pickand-place/controller-firmware/Schematic/Rev1.0/Schematic_rev1.0.pdf

## CAN_V3

## CAN_V3

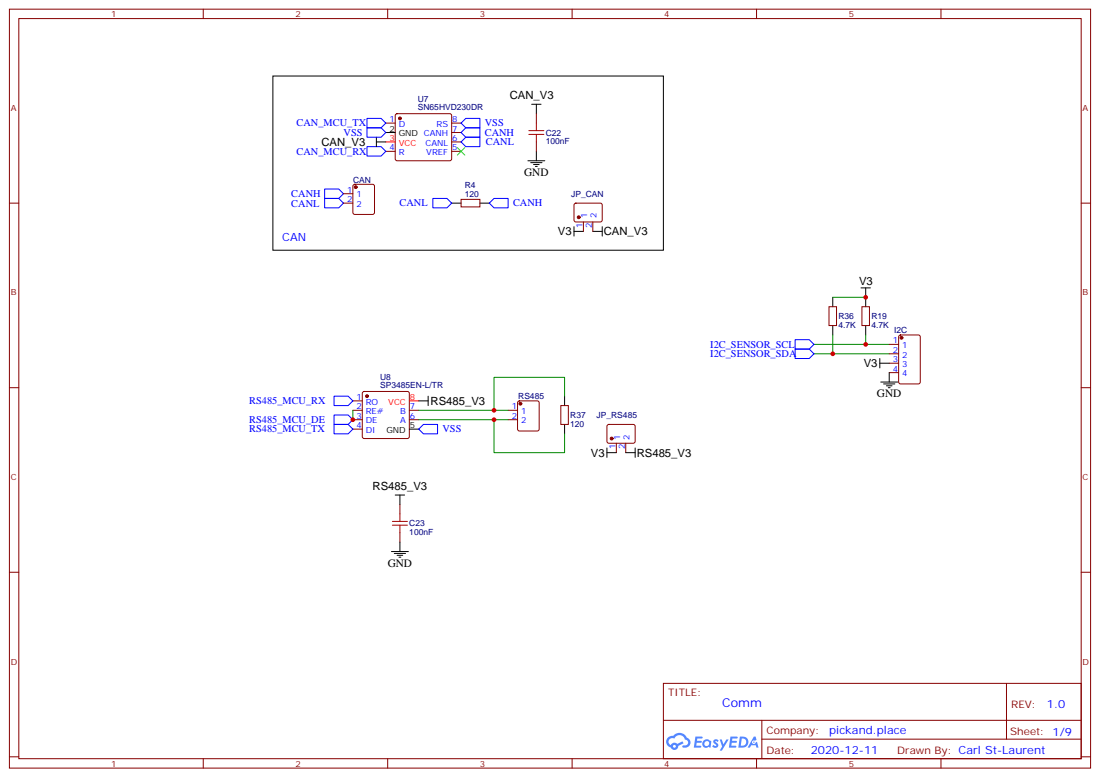
[picture p1: page 1]

Drawn By: Carl St-Laurent

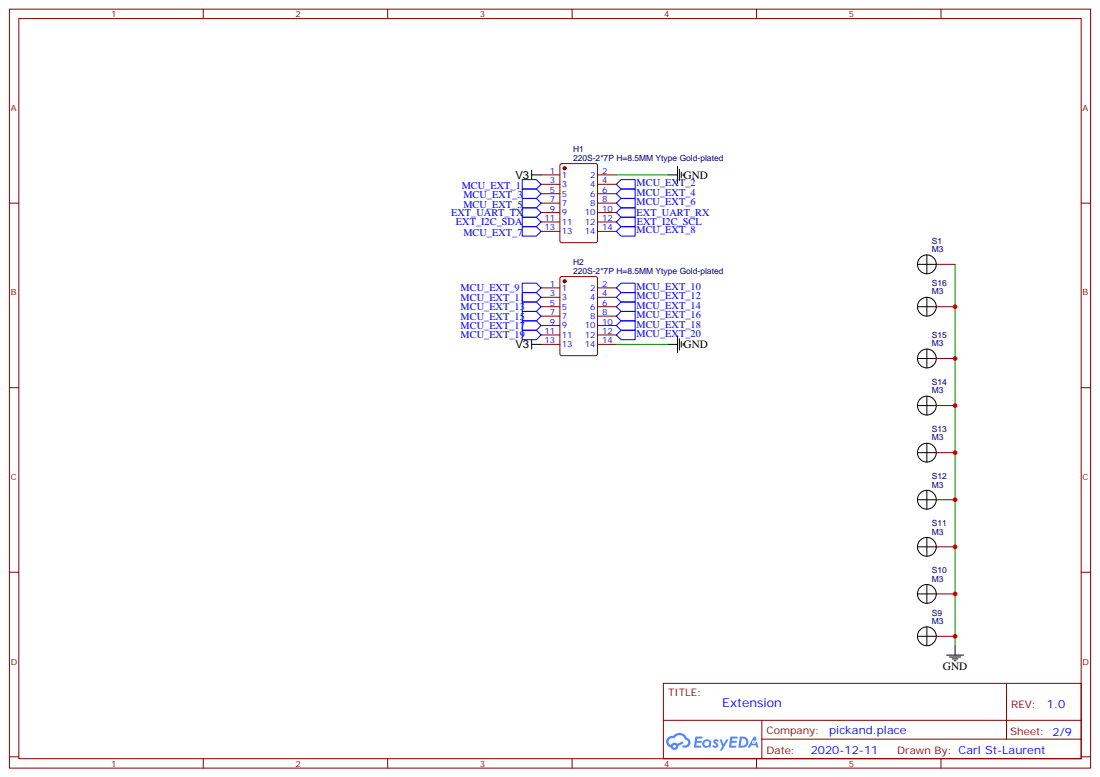
[picture p2: page 2]

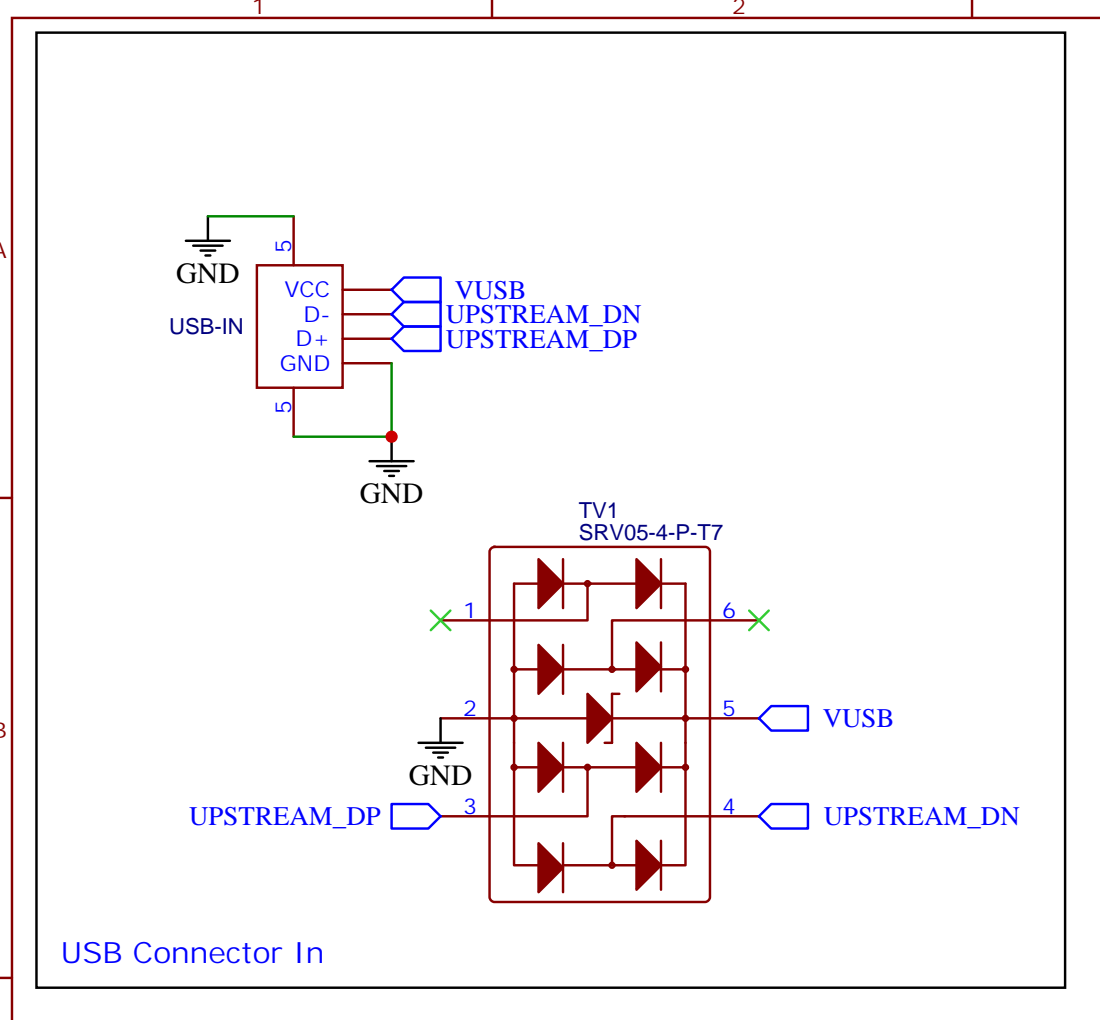
[picture p3: page 3]

## VIN

## Voltage In

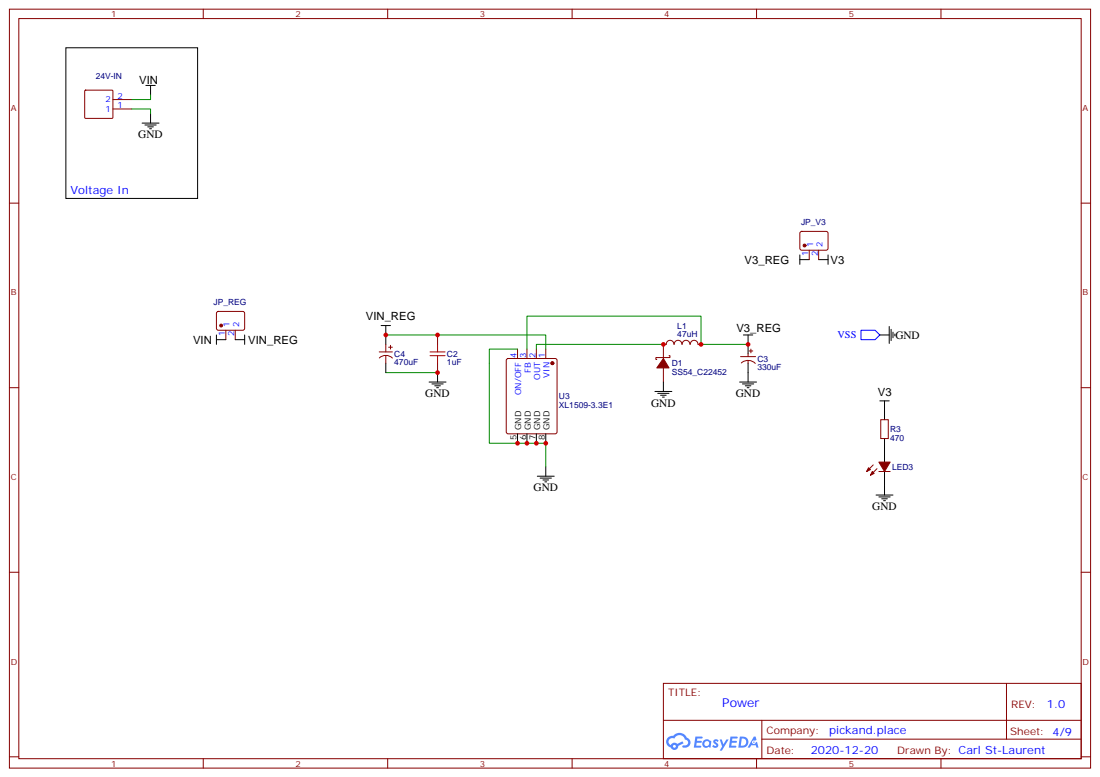
[picture p4: page 4]

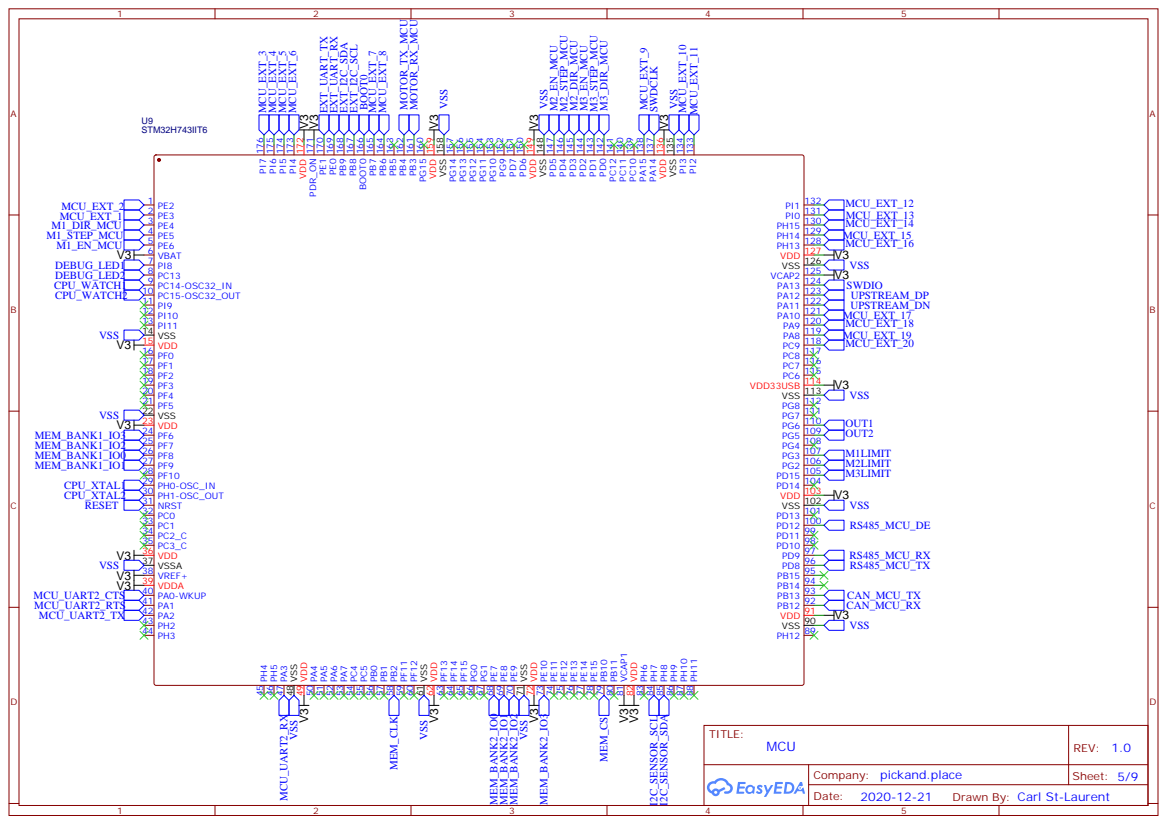
[picture p5: page 5]

V3

V3

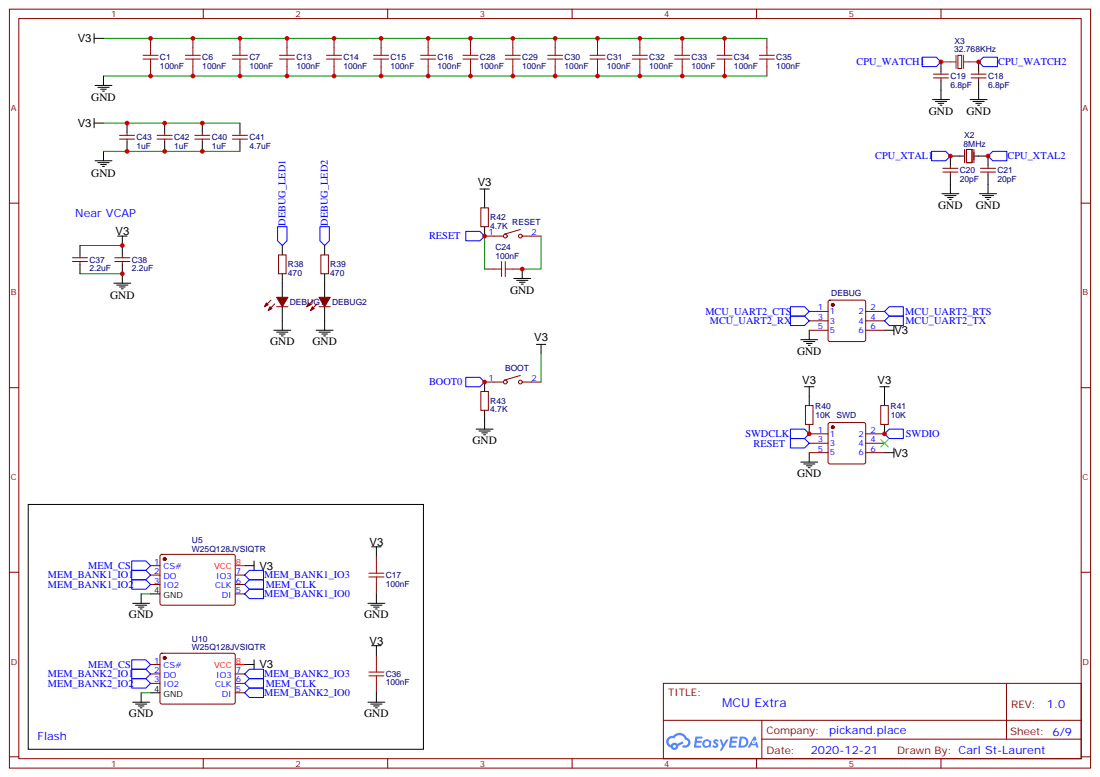
[picture p6: page 6]

## VIN

## VTMC

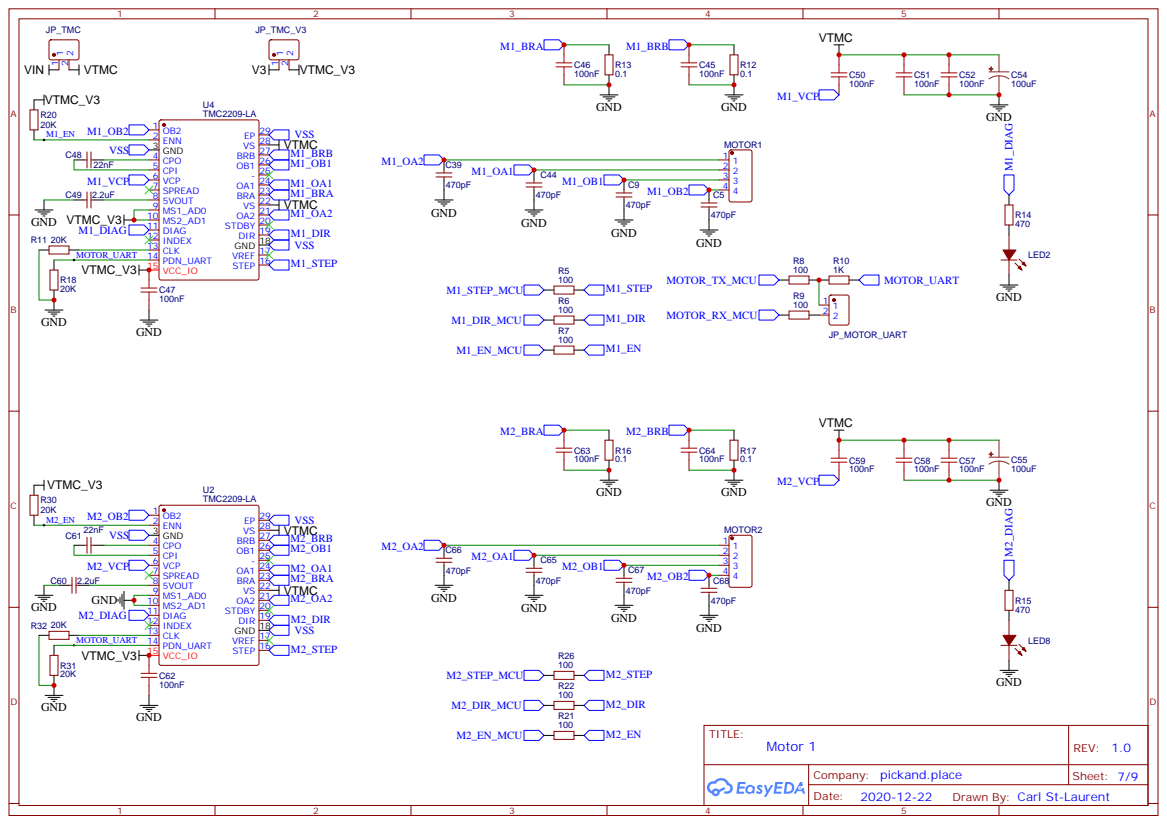
[picture p7: page 7]

## VTMC

## VTMC

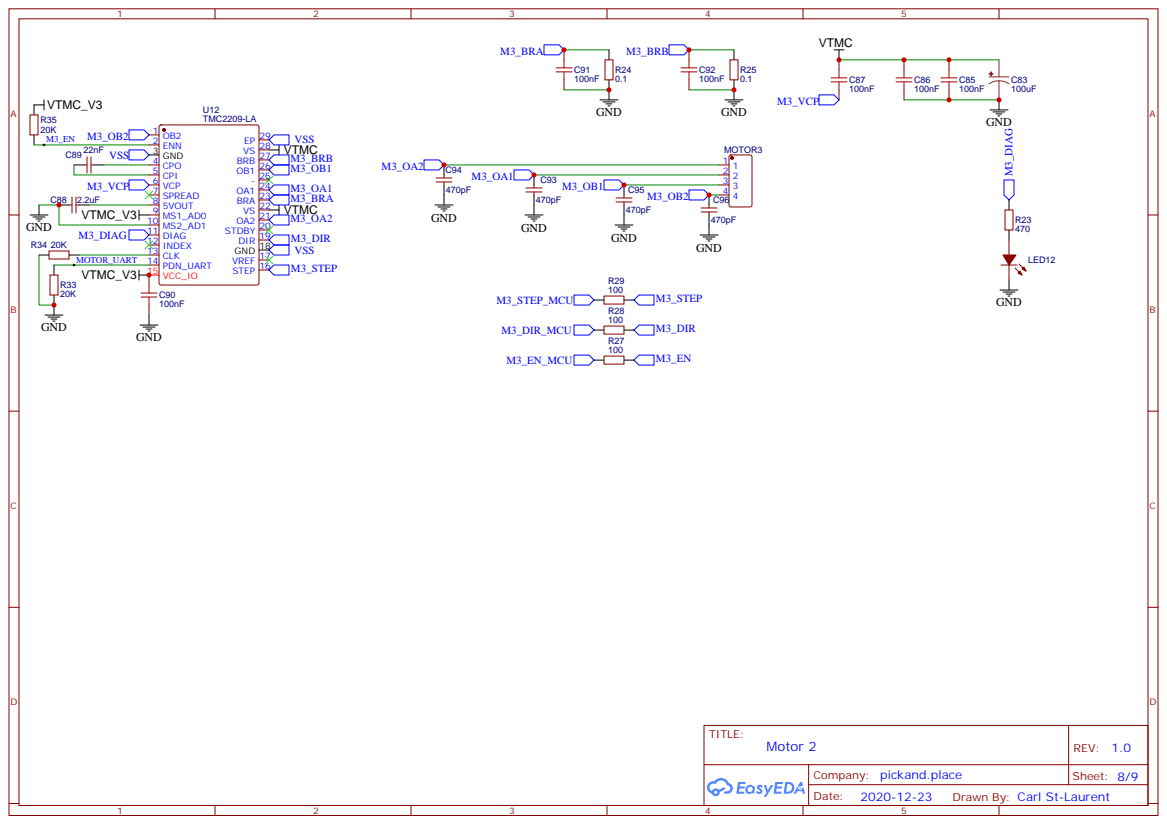
[picture p8: page 8]

V3

## VTMC

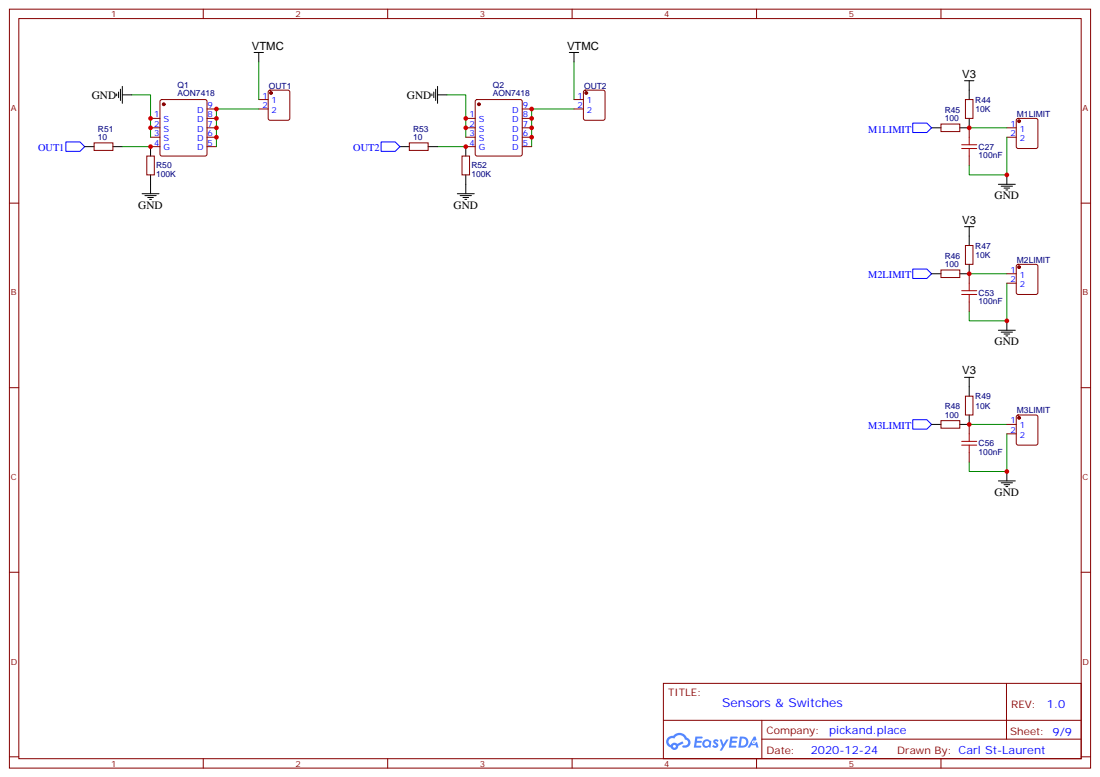
[picture p9: page 9]
