pickand-place/controller-firmware/Schematic/Rev1.0/Board_rev1.0.pdf

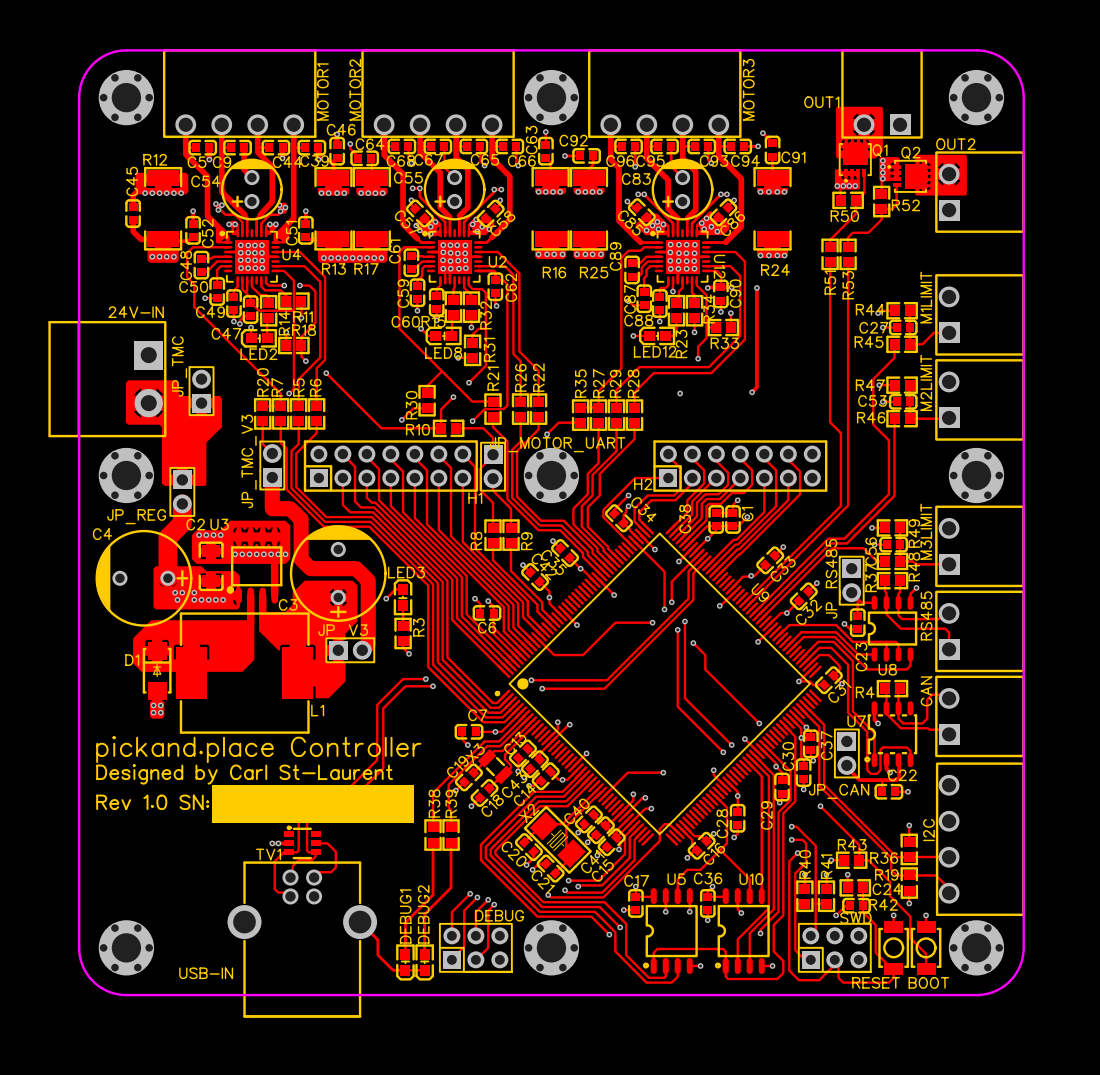
[picture p10: page 1]
