pickand-place/controller-firmware/Core/Src/main.c

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
/* Includes ------------------------------------------------------------------*/
#include "main.h"
#include "cmsis_os.h"

/* USER CODE BEGIN Includes */

#include "timers.h"

#include "tusb.h"

#include "usb_descriptors.h"

#include "retarget.h"
/* USER CODE END Includes */

typedef StaticTask_t osStaticThreadDef_t;
typedef StaticTimer_t osStaticTimerDef_t;
/* USER CODE BEGIN PD */

#define USBLED_PORT GPIOI
#define USBLED_PIN GPIO_PIN_8

#define DEBUGLED_PORT GPIOC
#define DEBUGLED_PIN GPIO_PIN_13

/* Blink pattern
 * - 250 ms  : device not mounted
 * - 1000 ms : device mounted
 * - 2500 ms : device is suspended
 */
enum {
	BLINK_NOT_MOUNTED = 250, BLINK_MOUNTED = 1000, BLINK_SUSPENDED = 2500,

	BLINK_ALWAYS_ON = UINT32_MAX, BLINK_ALWAYS_OFF = 0
};

static bool web_serial_connected = false;

#ifdef DEBUG
#define URL  "http://localhost:9999"
#else
	#define URL  "https://pickand.place"
#endif
const tusb_desc_webusb_url_t desc_url = { .bLength = 3 + sizeof(URL) - 1,
		.bDescriptorType = 3, // WEBUSB URL type
		.bScheme = 255, .url = URL };
/* USER CODE END PD */


CRC_HandleTypeDef hcrc;

FDCAN_HandleTypeDef hfdcan2;

I2C_HandleTypeDef hi2c1;
I2C_HandleTypeDef hi2c3;

QSPI_HandleTypeDef hqspi;

RNG_HandleTypeDef hrng;

RTC_HandleTypeDef hrtc;

UART_HandleTypeDef huart7;
UART_HandleTypeDef huart8;
UART_HandleTypeDef huart2;
UART_HandleTypeDef huart3;

PCD_HandleTypeDef hpcd_USB_OTG_FS;

/* Definitions for defaultTask */
osThreadId_t defaultTaskHandle;
const osThreadAttr_t defaultTask_attributes = {
  .name = "defaultTask",
  .stack_size = 128 * 4,
  .priority = (osPriority_t) osPriorityNormal,
};
/* Definitions for usbd */
osThreadId_t usbdHandle;
uint32_t usb_device_taskBuffer[ 256 ];
osStaticThreadDef_t usb_device_taskControlBlock;
const osThreadAttr_t usbd_attributes = {
  .name = "usbd",
  .cb_mem = &usb_device_taskControlBlock,
  .cb_size = sizeof(usb_device_taskControlBlock),
  .stack_mem = &usb_device_taskBuffer[0],
  .stack_size = sizeof(usb_device_taskBuffer),
  .priority = (osPriority_t) osPriorityRealtime6,
};
/* Definitions for usbled_timer */
osTimerId_t usbled_timerHandle;
osStaticTimerDef_t usbled_timerControlBlock;
const osTimerAttr_t usbled_timer_attributes = {
  .name = "usbled_timer",
  .cb_mem = &usbled_timerControlBlock,
  .cb_size = sizeof(usbled_timerControlBlock),
};
/* Definitions for debugled_timer */
osTimerId_t debugled_timerHandle;
osStaticTimerDef_t debugled_timerControlBlock;
const osTimerAttr_t debugled_timer_attributes = {
  .name = "debugled_timer",
  .cb_mem = &debugled_timerControlBlock,
  .cb_size = sizeof(debugled_timerControlBlock),
};
void SystemClock_Config(void);
void PeriphCommonClock_Config(void);
static void MX_GPIO_Init(void);
static void MX_CRC_Init(void);
static void MX_QUADSPI_Init(void);
static void MX_RNG_Init(void);
static void MX_USART2_UART_Init(void);
static void MX_USART3_UART_Init(void);
static void MX_RTC_Init(void);
static void MX_FDCAN2_Init(void);
static void MX_I2C1_Init(void);
static void MX_I2C3_Init(void);
static void MX_UART8_Init(void);
static void MX_UART7_Init(void);
static void MX_USB_OTG_FS_PCD_Init(void);
void StartDefaultTask(void *argument);
void usb_device_task(void *argument);
void usbled_timer_cb(void *argument);
void debugled_timer_cb(void *argument);

/**
  * @brief  The application entry point.
  * @retval int
  */
int main(void)
{
  /* Enable I-Cache---------------------------------------------------------*/
  SCB_EnableICache();

  /* Enable D-Cache---------------------------------------------------------*/
  SCB_EnableDCache();

  /* MCU Configuration--------------------------------------------------------*/

  /* Reset of all peripherals, Initializes the Flash interface and the Systick. */
  HAL_Init();

  /* Configure the system clock */
  SystemClock_Config();

/* Configure the peripherals common clocks */
  PeriphCommonClock_Config();

  /* Initialize all configured peripherals */
  MX_GPIO_Init();
  MX_CRC_Init();
  MX_QUADSPI_Init();
  MX_RNG_Init();
  MX_USART2_UART_Init();
  MX_USART3_UART_Init();
  MX_RTC_Init();
  MX_FDCAN2_Init();
  MX_I2C1_Init();
  MX_I2C3_Init();
  MX_UART8_Init();
  MX_UART7_Init();
  MX_USB_OTG_FS_PCD_Init();
  /* USER CODE BEGIN 2 */
  RetargetInit(&huart2);
  HAL_GPIO_WritePin(DEBUGLED_PORT, DEBUGLED_PIN, 1);
  /* USER CODE END 2 */

  /* Init scheduler */
  osKernelInitialize();

  /* USER CODE BEGIN RTOS_MUTEX */
	/* add mutexes, ... */
  /* USER CODE END RTOS_MUTEX */

  /* USER CODE BEGIN RTOS_SEMAPHORES */
	/* add semaphores, ... */
  /* USER CODE END RTOS_SEMAPHORES */

  /* Create the timer(s) */
  /* creation of usbled_timer */
  usbled_timerHandle = osTimerNew(usbled_timer_cb, osTimerPeriodic, NULL, &usbled_timer_attributes);

  /* creation of debugled_timer */
  debugled_timerHandle = osTimerNew(debugled_timer_cb, osTimerPeriodic, NULL, &debugled_timer_attributes);

  /* USER CODE BEGIN RTOS_TIMERS */
	/* start timers, add new ones, ... */

  /* USER CODE END RTOS_TIMERS */

  /* USER CODE BEGIN RTOS_QUEUES */
	/* add queues, ... */
  /* USER CODE END RTOS_QUEUES */

  /* Create the thread(s) */
  /* creation of defaultTask */
  defaultTaskHandle = osThreadNew(StartDefaultTask, NULL, &defaultTask_attributes);

  /* creation of usbd */
  usbdHandle = osThreadNew(usb_device_task, NULL, &usbd_attributes);

  /* USER CODE BEGIN RTOS_THREADS */
	/* add threads, ... */

  /* USER CODE END RTOS_THREADS */

  /* USER CODE BEGIN RTOS_EVENTS */
	/* add events, ... */
  /* USER CODE END RTOS_EVENTS */

  /* Start scheduler */
  osKernelStart();

  /* We should never get here as control is now taken by the scheduler */
  /* Infinite loop */
  /* USER CODE BEGIN WHILE */
	while (1) {
    /* USER CODE END WHILE */

    /* USER CODE BEGIN 3 */
	}
  /* USER CODE END 3 */
}

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
/* USER CODE BEGIN 4 */

void board_led_write(bool state) {
	HAL_GPIO_WritePin(USBLED_PORT, USBLED_PIN, state);
}

// send characters to both CDC and WebUSB
void echo_all(uint8_t buf[], uint32_t count) {
	// echo to web serial
	if (web_serial_connected) {
		tud_vendor_write(buf, count);
	}
}

// Invoked when device is mounted
void tud_mount_cb(void) {
	xTimerChangePeriod(usbled_timerHandle, pdMS_TO_TICKS(BLINK_MOUNTED), 0);
}

// Invoked when device is unmounted
void tud_umount_cb(void) {
	xTimerChangePeriod(usbled_timerHandle, pdMS_TO_TICKS(BLINK_NOT_MOUNTED), 0);
}

// Invoked when usb bus is suspended
// remote_wakeup_en : if host allow us  to perform remote wakeup
// Within 7ms, device must draw an average of current less than 2.5 mA from bus
void tud_suspend_cb(bool remote_wakeup_en) {
	(void) remote_wakeup_en;
	xTimerChangePeriod(usbled_timerHandle, pdMS_TO_TICKS(BLINK_SUSPENDED), 0);
}

// Invoked when usb bus is resumed
void tud_resume_cb(void) {
	xTimerChangePeriod(usbled_timerHandle, pdMS_TO_TICKS(BLINK_MOUNTED), 0);
}

bool tud_vendor_control_request_cb(uint8_t rhport,
		tusb_control_request_t const *request) {
	switch (request->bRequest) {
	case VENDOR_REQUEST_WEBUSB:
		// match vendor request in BOS descriptor
		// Get landing page url
		return tud_control_xfer(rhport, request, (void*) &desc_url,
				desc_url.bLength);

	case VENDOR_REQUEST_MICROSOFT:
		if (request->wIndex == 7) {
			// Get Microsoft OS 2.0 compatible descriptor
			uint16_t total_len;
			memcpy(&total_len, desc_ms_os_20 + 8, 2);

			return tud_control_xfer(rhport, request, (void*) desc_ms_os_20,
					total_len);
		} else {
			return false;
		}
	case 0x22:
		// Webserial simulate the CDC_REQUEST_SET_CONTROL_LINE_STATE (0x22) to
		// connect and disconnect.
		web_serial_connected = (request->wValue != 0);

		// Always lit LED if connected
		if (web_serial_connected) {
			board_led_write(true);
			xTimerChangePeriod(usbled_timerHandle,
					pdMS_TO_TICKS(BLINK_ALWAYS_ON), 0);

			tud_vendor_write_str("\r\nTinyUSB WebUSB device example\r\n");
		} else {
			xTimerChangePeriod(usbled_timerHandle, pdMS_TO_TICKS(BLINK_MOUNTED),
					0);
		}

		// response with status OK
		return tud_control_status(rhport, request);

	default:
		// stall unknown request
		return false;
	}

	return true;
}

// Invoked when DATA Stage of VENDOR's request is complete
bool tud_vendor_control_complete_cb(uint8_t rhport,
		tusb_control_request_t const *request) {
	(void) rhport;
	(void) request;

	// nothing to do
	return true;
}

/* USER CODE END 4 */

/* USER CODE BEGIN Header_StartDefaultTask */
/**
 * @brief  Function implementing the defaultTask thread.
 * @param  argument: Not used
 * @retval None
 */
/* USER CODE END Header_StartDefaultTask */
void StartDefaultTask(void *argument)
{
  /* USER CODE BEGIN 5 */
	osTimerStart(debugled_timerHandle, pdMS_TO_TICKS(100));
	osTimerStart(usbled_timerHandle, pdMS_TO_TICKS(BLINK_NOT_MOUNTED));
	/* Infinite loop */
	for (;;) {
		osDelay(1000);
		printf("\r\nHello");
	}
  /* USER CODE END 5 */
}

/* USER CODE BEGIN Header_usb_device_task */
/**
 * @brief Function implementing the usbd thread.
 * @param argument: Not used
 * @retval None
 */
/* USER CODE END Header_usb_device_task */
void usb_device_task(void *argument)
{
  /* USER CODE BEGIN usb_device_task */
	tusb_init();
	/* Infinite loop */
	for (;;) {
		tud_task();
	}
  /* USER CODE END usb_device_task */
}

/* usbled_timer_cb function */
void usbled_timer_cb(void *argument)
{
  /* USER CODE BEGIN usbled_timer_cb */
	(void) argument;
	static bool led_state = false;

	board_led_write(led_state);
	led_state = 1 - led_state; // toggle
  /* USER CODE END usbled_timer_cb */
}

/* debugled_timer_cb function */
void debugled_timer_cb(void *argument)
{
  /* USER CODE BEGIN debugled_timer_cb */
	static bool debug_led_state = false;

	HAL_GPIO_WritePin(DEBUGLED_PORT, DEBUGLED_PIN, debug_led_state);
	debug_led_state = 1 - debug_led_state; // toggle

  /* USER CODE END debugled_timer_cb */
}

 /**
  * @brief  Period elapsed callback in non blocking mode
  * @note   This function is called  when TIM2 interrupt took place, inside
  * HAL_TIM_IRQHandler(). It makes a direct call to HAL_IncTick() to increment
  * a global variable "uwTick" used as application time base.
  * @param  htim : TIM handle
  * @retval None
  */
void HAL_TIM_PeriodElapsedCallback(TIM_HandleTypeDef *htim)
{
  if (htim->Instance == TIM2) {
    HAL_IncTick();
  }
}

/**
  * @brief  This function is executed in case of error occurrence.
  * @retval None
  */
void Error_Handler(void)
{
  /* USER CODE BEGIN Error_Handler_Debug */
	/* User can add his own implementation to report the HAL error return state */
	__disable_irq();
	while (1) {
	}
  /* USER CODE END Error_Handler_Debug */
}

#ifdef  USE_FULL_ASSERT
/**
  * @brief  Reports the name of the source file and the source line number
  *         where the assert_param error has occurred.
  * @param  file: pointer to the source file name
  * @param  line: assert_param error line source number
  * @retval None
  */
void assert_failed(uint8_t *file, uint32_t line)
{
  /* USER CODE BEGIN 6 */
  /* User can add his own implementation to report the file name and line number,
     ex: printf("Wrong parameters value: file %s on line %d\r\n", file, line) */
  /* USER CODE END 6 */
}
#endif /* USE_FULL_ASSERT */

/************************ (C) COPYRIGHT STMicroelectronics *****END OF FILE****/
