pickand-place/controller-firmware/Core/Inc/main.h

#define EXT_2_Pin GPIO_PIN_2
#define EXT_2_GPIO_Port GPIOE
#define EXT_1_Pin GPIO_PIN_3
#define EXT_1_GPIO_Port GPIOE
#define M1_DIR_Pin GPIO_PIN_4
#define M1_DIR_GPIO_Port GPIOE
#define M1_STEP_Pin GPIO_PIN_5
#define M1_STEP_GPIO_Port GPIOE
#define M1_EN_Pin GPIO_PIN_6
#define M1_EN_GPIO_Port GPIOE
#define DEBUG_LED1_Pin GPIO_PIN_8
#define DEBUG_LED1_GPIO_Port GPIOI
#define DEBUG_LED2_Pin GPIO_PIN_13
#define DEBUG_LED2_GPIO_Port GPIOC
#define DEBUG_TX_Pin GPIO_PIN_2
#define DEBUG_TX_GPIO_Port GPIOA
#define DEBUG_RX_Pin GPIO_PIN_3
#define DEBUG_RX_GPIO_Port GPIOA
#define LIMIT_M3_Pin GPIO_PIN_15
#define LIMIT_M3_GPIO_Port GPIOD
#define LIMIT_M2_Pin GPIO_PIN_2
#define LIMIT_M2_GPIO_Port GPIOG
#define LIMIT_M1_Pin GPIO_PIN_3
#define LIMIT_M1_GPIO_Port GPIOG
#define OUT2_Pin GPIO_PIN_5
#define OUT2_GPIO_Port GPIOG
#define OUT1_Pin GPIO_PIN_6
#define OUT1_GPIO_Port GPIOG
#define EXT_20_Pin GPIO_PIN_9
#define EXT_20_GPIO_Port GPIOC
#define EXT_19_Pin GPIO_PIN_8
#define EXT_19_GPIO_Port GPIOA
#define EXT_18_Pin GPIO_PIN_9
#define EXT_18_GPIO_Port GPIOA
#define EXT_17_Pin GPIO_PIN_10
#define EXT_17_GPIO_Port GPIOA
#define USB_DM_Pin GPIO_PIN_11
#define USB_DM_GPIO_Port GPIOA
#define USB_DP_Pin GPIO_PIN_12
#define USB_DP_GPIO_Port GPIOA
#define EXT_16_Pin GPIO_PIN_13
#define EXT_16_GPIO_Port GPIOH
#define EXT_15_Pin GPIO_PIN_14
#define EXT_15_GPIO_Port GPIOH
#define EXT_14_Pin GPIO_PIN_15
#define EXT_14_GPIO_Port GPIOH
#define EXT_13_Pin GPIO_PIN_0
#define EXT_13_GPIO_Port GPIOI
#define EXT_12_Pin GPIO_PIN_1
#define EXT_12_GPIO_Port GPIOI
#define EXT_11_Pin GPIO_PIN_2
#define EXT_11_GPIO_Port GPIOI
#define EXT_10_Pin GPIO_PIN_3
#define EXT_10_GPIO_Port GPIOI
#define EXT_9_Pin GPIO_PIN_15
#define EXT_9_GPIO_Port GPIOA
#define M3_DIR_Pin GPIO_PIN_0
#define M3_DIR_GPIO_Port GPIOD
#define M3_STEP_Pin GPIO_PIN_1
#define M3_STEP_GPIO_Port GPIOD
#define M3_EN_Pin GPIO_PIN_2
#define M3_EN_GPIO_Port GPIOD
#define M2_DIR_Pin GPIO_PIN_3
#define M2_DIR_GPIO_Port GPIOD
#define M2_STEP_Pin GPIO_PIN_4
#define M2_STEP_GPIO_Port GPIOD
#define M2_EN_Pin GPIO_PIN_5
#define M2_EN_GPIO_Port GPIOD
#define EXT8_Pin GPIO_PIN_6
#define EXT8_GPIO_Port GPIOB
#define EXT7_Pin GPIO_PIN_7
#define EXT7_GPIO_Port GPIOB
#define EXT6_Pin GPIO_PIN_4
#define EXT6_GPIO_Port GPIOI
#define EXT5_Pin GPIO_PIN_5
#define EXT5_GPIO_Port GPIOI
#define EXT4_Pin GPIO_PIN_6
#define EXT4_GPIO_Port GPIOI
#define EXT3_Pin GPIO_PIN_7
#define EXT3_GPIO_Port GPIOI
