pickand-place/controller-firmware/(commit log)

2020-12-31 initial stm32 project
2021-01-01 Debug led usb state and proper usb callback implementation
2021-01-22 DO NOT CHANGE THIS, or it bricks the board
2021-01-23 debug led, usb still bricks the chip
2021-01-23 Retargeting of printf on uart2 for debugging
2021-01-24 Forward usb interrupt to tinyusb, working connection
2021-02-09 Added Rev 1 Board and Schematic as reference
2021-02-10 Added readme to Rev 1.0 schematic
2021-03-22 Build upgrade to STM32Cube 1.6 and tinyusb 0.9 (#3)
    * Started upgrade
    * Tinyusb 0.9
    * longer print delay
